Alan-Gray/Axial-flux-electric-motor-project/README.md

# Axial-flux-electric-motor-project

<!--![final 3d printerd](https://github.com/user-attachments/assets/55846419-a8b6-457b-be80-7e71b974730b)-->

n38 coreless

https://github.com/user-attachments/assets/0240cb34-20bc-444c-a97b-04bdd0747461 

<!-- <img width="500" height="500" alt="n38 coreless" src="https://github.com/user-attachments/assets/3e4906e7-9eda-4006-9bef-0d93576fb85e" /> -->

Over the past year I have become increasingly interested in electric motors. I built a small axial flux generator as part of a university course and had alot of fun building it, but there were many things I could've done better. My goal for this project was to refine my previous design to run as a motor and to create a more efficient machine. My focus for this project was making the shaft spin well, reducing the airgap, and improving the electrical and magnetic design of the motor.

## Disclaimer : 
As I have been writing this over the course of the project, some parts might be out of date. I have been working on a single rotor design as it allows a simpler stator construction and I am currently testing its performance. Some sections might be out of date and Ill update them as soon as I can. Enjoy! 

## Design summary

### General Specifications

| Motor Type | BLDC |
|:-- | :--: |
| Case Outer Diameter | 110 mm | 
| Case Length | 60 mm |  
| Shaft Diameter | 10 mm |
| Cost | £100 | 

### Motor Specifications 
| Motor Topology | Double-sided Axial flux |
|:-- | :--: |
| Air Gap | 1 mm | 
| Number of Poles | 16 |
| Number of Coils | 12 |
| Number of Phases | 3 | 
| Turns per Coil | 50 | 
| Wire Thickness | 1 mm | 
| Impedance per Coil | 0.2 &Omega; |
| Inductance per Coil | 15 &micro;H |

### Materials 
| Magnetic Material | N52 Neodymium | 
|:-- | :--: |
| Magnet Dimensions | 20 mm x 10 mm x 5 mm | 
| Core Material | 430 Stainless Steel | 
| Case, Rotor and Shaft Material | PLA | 
| Manufacturing Techniques | 3D printing, Water-jet Cutting |
