Alan-Gray/Axial-flux-electric-motor-project/Mechanical Design and CAD/README.md

# CAD and Mechanical Design
|CAD 1| CAD 1|
|:--:| :--: |
| *CAD model of final design* | *The three versions of the mechanical design* |

I had two goals for the mechanical design of the motor:
* Make the shaft spin well
* Make it easy to assemble

I made the CAD models in Fusion 360. I used an iterative design approach, where I would 3D print parts and see how they perform. After 3 versions, I landed on a design I was happy. 

## Shaft and rotor design
The biggest challange I faced was deciding how to attach the rotors to the shaft. I went throught many different versions, and eventually landed on a more modular design. 

|shaft with hubs| Rotor and rotor hub |
|:--:| :--:|
|*Shaft and rotor hubs*| *Rotor and Rotor hubs*|

The main reason I went for this design is that it lets me change the rotor hub design without needing to completely remake the rotor. Magnets are expensive, and I didn't want to glue the magnets to the rotor only to realize it doesnt fit on the shaft correctly. The hubs screw onto the shaft, and the rotor screws onto the plate. Whilst I was initially happy with the design, there were a couple flaws that became apparent whilst I was assembling the motor for the first time...

## The motor imploded (whoops)
Whilst 3D-printing the shaft was great for speed, it is **not** strong enough to keep thirty-two N52 magnets from being apart. This was also in part due to my rotor-and-rotor-hub design; when I tried to put on the second rotor, I didnt put it on fully straight, causing a massive imbalance and putting a big bending force on the shaft, which promtly broke in half. 

|  | |
|:--:| :--:|
|*The two rotors a bit closer than I would like them to be...*| *not my proudest moment*|

The magnets were unharmed and could be salvaged, but it was painfully clear that I need to redesign how I attach the rotors on the shaft. I was too focused on making it easy to assemble that I didn't consider that it needs to be strong enough. For testing purposes, I rebuilt the current design with only one rotor, but the design needs to be changed. The first thing to improve is make the shaft out of a stronger material like steel, and to make the rotor a single peice. I'm actively working on this currently, and Ill update the page once I've made something that works well.
