Alan-Gray/Axial-flux-electric-motor-project/Simulations and Magnetic Design/README.md

# Magnetic Simulations
My goal for my simulations was to compare different designs and accurately determine the magnetic field density in the motor. To do this, I used a mix of 2D and 3D simulations. 

## 2D Simulations: 
The 2D simulations were used to compare my different ideas for the magnetic design. In particualr, I wanted to analyse how stator cores and rotor backing iron would affect the motor performance. My 2D simulations were made using FEMM 4.2.

### Simulations: 3mm magnets
| N38 Coreless| N38 Iron Core |
| :---: | :---: |
| n38 coreless |  n38 core |
| **N52 Coreless** | **N52 Iron Core** |
| n52 coreless | n52 core |

|3mm magnet graph|
|:--:| 
| *Graph of magnetic field strength across coil centres* |

### Simulations: 5mm magnets
| N38 Coreless| N38 Iron Core |
| :---: | :---: |
| n38 coreless | n38 core |
| **N52 Coreless** | **N52 Iron Core** |
| n52 coreless | n52 core|
   
|5mm magnet graph|
|:--:| 
| *Graph of magnetic field strength across coil centres* |

## 3D Simulations: 
|sim3|
|:--:| 
| *3D magetic simulation* |
Whilst I had a good amount of experience using 2D simulations, 3D simulations were something new for this project. Orignially, I wanted to use ANSYS Maxwell. However, the student license imposed a mesh limit, making it hard for me simulate the full motor. 

After some searching, I found that some of the university computers had a full license of ANSYS Workbench. It was older and had less features, it was sufficient for my use case.  

|2mm rotor 3|
|:--:|
|*3D magnetic simulation*|

## Learning more about FEA 
Whilst I was looking for a different software to use, I found an open source solver called Elmer. It was more complex and hard to use but it forced me to understand more about finite element simulaitions and how they work. 

||
|:--:|
| *Tutorial simulation made in Elmer* |

|, |
|:--:|
|*Le image*|
