Alan-Gray/Axial-flux-electric-motor-project/CAD Design/README.md

# CAD Model and Design
|CAD 1|
|:--:| 
| *Final design for the CAD model* |

My CAD model was made in Fusion 360.
