Alan-Gray/Axial-flux-electric-motor-project/Magnetic Simulations/README.md

# Magnetic Simulations
My goal for my simulations was to compare different designs and determine the magnetic field density in the motor. To do this, I used a mix of 2D and 3D simulations. The 2D simulations were made in FEMM 4.2 and the 3D simulations were made in ANSYS Workbench.

## 2D Simulations: 
The 2D simulations were used to compare my different ideas for the magnetic design. In particualr, I wanted to analyse how stator cores and rotor backing iron would affect the motor performance. I also wanted to determine what magnet grade to use. These were rough comparisons as you cant fully simulate an axial flux motor in two dimensions, but they were still very useful to get an idea of what matters to produce a strong magnetic field.  

### Simulations : 5mm magnets - Coreless vs Cored stator coils
| N38 Coreless| N38 Iron Core |
| :---: | :---: |
| n38 coreless | n38 core |
| **N52 Coreless** | **N52 Iron Core** |
| n52 coreless | n52 core|
   
|5mm magnet graph|
|:--:| 
| *Graph of magnetic field strength across coil centres. The magnetic field density is measured in the middle of the core going from top to bottom.* |

### Simulations : 5mm magnets - Rotor Backing Iron vs No Rotor Backing Iron 
| **N52 Coreless** | **N52 Iron Core** |
| :---: | :---: |
| iron core no rotor iron pic| iron core and rotor iron |
| iron core no rotor iron | iron core and rotor iron graph |

I knew that stator cores and rotor backing iron would improve performance, but I didn't realise how much of an improvement it would be. Using stator cores more than doubles the magnetic field density, and rotor backing iron doubles it again. The simulations assume the magnetic material is iron which won't be the case for my motor (its to expensive), but it is still clear that I should include both stator cores and backing iron in the motor.   

The N52 magnets had roughly 16% higher magnetic field density than the N38 magnets, which alligns with datasheets available online. N38 magnets are much cheaper, which can be appealing if you're buying them in bulk. I'll be making a small order so I chose to use the N52 magnets. 

## 3D Simulations: 
After deciding to include both stator cores and rotor backing iron in the motor, I stared working on the 3D simulations to validate my findings and determine a more accurate figure for the magnetic field density. Whilst I had a good amount of experience using 2D simulations, 3D simulations were something new for this project. 

Orignially, I wanted to use ANSYS Maxwell. However, the student license imposed a mesh limit, making it hard for me simulate the full motor. After some searching, I found that some of the university computers had a full license of ANSYS Workbench. It was older and had less features, but it was sufficient for my use case. I had to do alot of troubleshooting to get it working and it was very satifying to see the first results of the simulations.

|sim3|
|:--:| 
|2mm rotor 3|
|:--:|
|*3D magnetic simulations*|

I got a couple insights from the 3D simulations that I previously hadn't considered. First, the centre of the rotor backing iron doesnt carry any flux (as seen above in the grey zone on the backing iron) meaning it can be removed without any decrease in magnetic performance. Secondly, only the stator cores should be made out of ferromagnetic material or wierd flux paths arise (within the stator). I originally thought I would need to maximize the surface that could "catch" the magnetic field, but this assumption was incorrect. When the only ferromagnetic part of the stator are the cores, all of the flux gets focused down them, increasing the magnetic field density. 

## Learning more about FEA 
Whilst I was looking for a different software to use, I found an open source program called Elmer GUI. It was more complex and hard to use but it forced me to understand more about finite element simulaitions and how they work. This included making my own mesh from step files using GMSH and playing around with non linear and linear convergence tolerances and iteration counts. Whilst I couldn't get my own simulations working, it was a valuable learning experience. 

||
|:--:|
| *My first simulation in elmer after following an online tutorial* |

|mesh |
|:--:|
|*mesh made in GMSH and imported into Elmer GUI*|
