Alan-Gray/Axial-flux-electric-motor-project/(list of files, cad)

Other CAD files:
Mechanical Design and CAD/Motor CAD.obj
