Alan-Gray/Axial-flux-electric-motor-project/(commit log)

2025-08-08 Rename Motor CAD.f3d to Motor CAD.f3d
    [Motor CAD.f3d]
2025-08-08 Update and rename Motor CAD.mtl to Motor CAD.mtl
2025-08-08 Rename Motor CAD.obj to Motor CAD.obj
    [Motor CAD.obj]
2025-09-08 Create Estimating power output.md
2025-09-08 Rename Estimating power output.md to Estimating power output/README.md
2025-09-18 Update and rename Motor CAD.f3d to Motor CAD.f3d
    [Motor CAD.f3d]
2025-09-18 Update and rename CAD and Mechanical Design/Motor CAD.mtl to Mechanical Design and CADMotor CAD.mtl
2025-09-18 Update and rename CAD and Mechanical Design/Motor CAD.obj to Mechanical Design and CADMotor CAD.obj
    [Mechanical Design and CADMotor CAD.obj]
2025-09-18 Update and rename Mechanical Design and CADMotor CAD.obj to Mechanical Design and CAD/Motor CAD.obj
    [Motor CAD.obj]
2025-09-18 Update and rename Mechanical Design and CADMotor CAD.mtl to Mechanical Design and CAD/Motor CAD.mtl
